klebermc/ALOS/presentation/ICCSPA2019_slides.pdf

## ALOS: Acoustic Localization System Applied to Indoor Navigation of UAVs

Kleber M. Cabral, Sergio R. B. dos Santos, Cairo L. Nascimento Jr, Sidney N. Givigi Jr.

# Agenda

- Introduction
- Position estimation problem.
- Proposed system architecture
- ALOS
- Localization algorithm
- Kalman Filter
- Results
- physical experiment using ALOS
- simulation trials
- Conclusion

# Position estimation

- Indoor environments are GPS denied
- Multiple technologies were studied throughout the years
- Infrared camera systems (OptiTrack, Vicon)
- Electromagnetic signals
- WiFi, Zigbee, Bluetooth (received power)
- UWB (TOF)
- Acoustic waves (TOF)

# Position estimation

- In general, the accuracy in position estimation with the technologies presented is:
- camera systems - centimeters or milimeters
- received power electromagnetic systems - meters or UWB - centimeters
- acoustic waves - centimeters

# Position estimation using trilateration

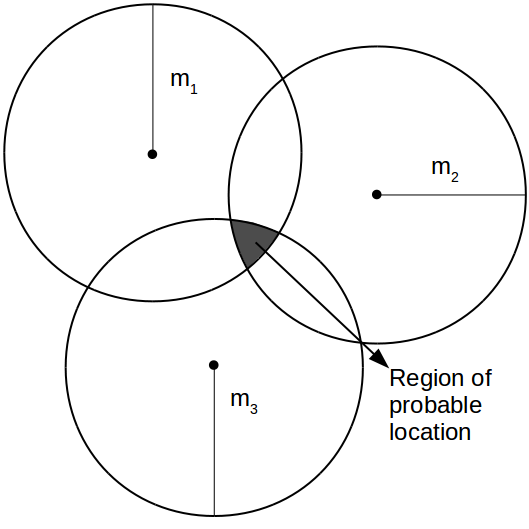
[picture p26: figure]

- It is possible to measure
the distance (mi) from a
source to a receiver
using ultrasonic sensors
- Using multiple sources,
one can calculate the
position of a receiver
with a trilateration
algorithm

# Objective

To build an ultrasonic-based indoor navigation system that is capable of compute the position and orientation of multiple aerial vehicles in real-time operation

# System proposed

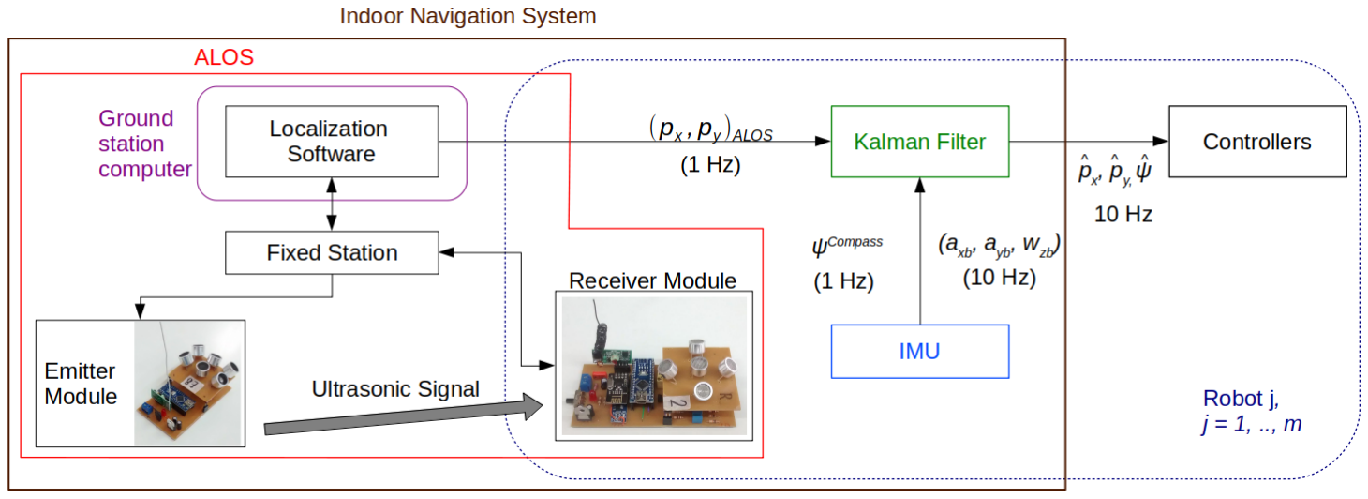
[picture p27: figure]

## ALOS (Acoustic Localization System)

- Uses ultrasonic signals to measure the distances between fixed ultrasonic emitter modules and a ultrasonic receiver coupled to a robot
- Two radio frequency channels for communication:
- 433 MHz - synchronization of operation
- 2.4 GHz - data transfer
- Uses time windows to allocate and organize the measurements of TOF. At each time window, only one of the eight emitters sends ultrasonic pulses to the environment.
- Return the position of all receiver modules every second (1 Hz)

# ALOS

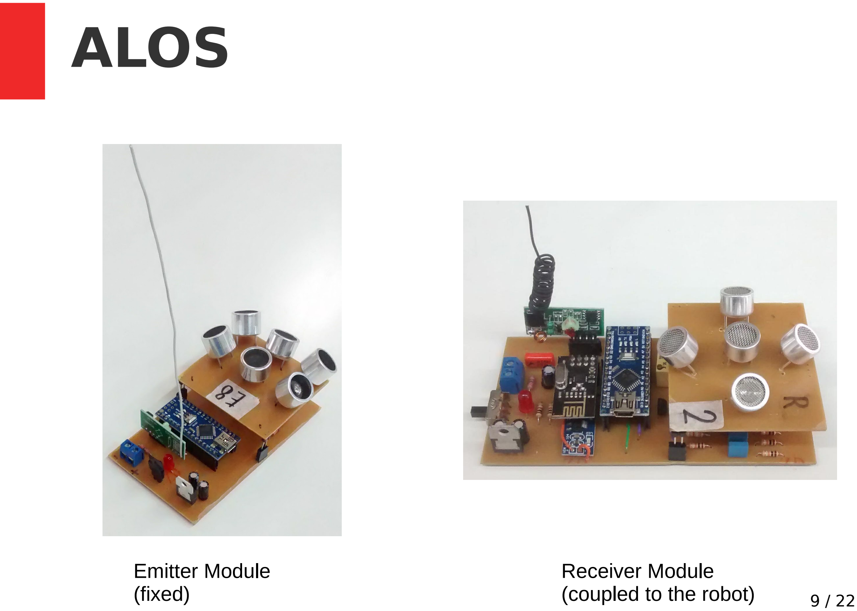
[picture p28: page 9]

Emitter Module
(fixed)

Receiver Module
(coupled to the robot)

# ALOS

- A received ultrasonic signal passes through a conditioning circuit inside Receiver Module, before being detected by the module’s microcontroller.

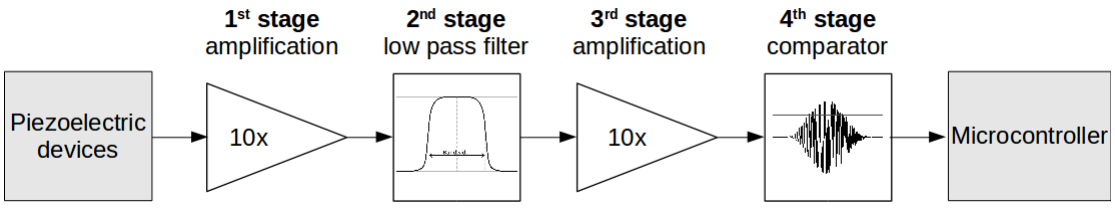
[picture p29: figure]

# ALOS: Trilateration Algorithm

- The position of a receiver module is computed by the trilateration algorithm, that uses a Taylor Series approximation of the distances measured by each ultrasonic signal.

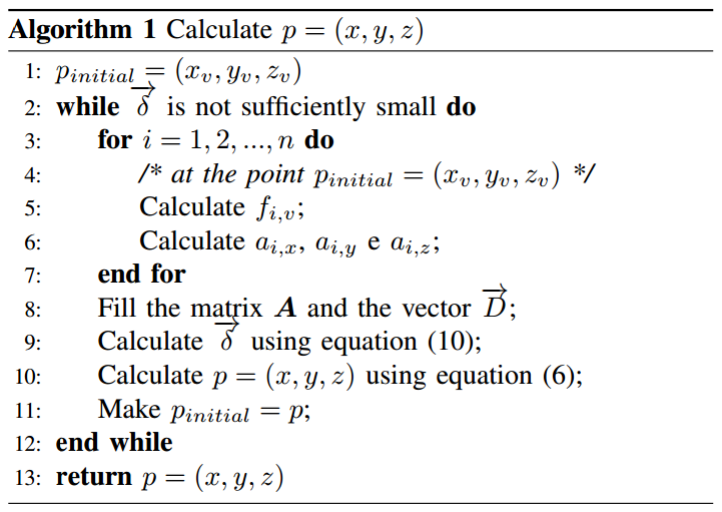
[picture p30: figure]

## Kalman Filter – Sensor fusion and Pose estimation


# Results physical experiment

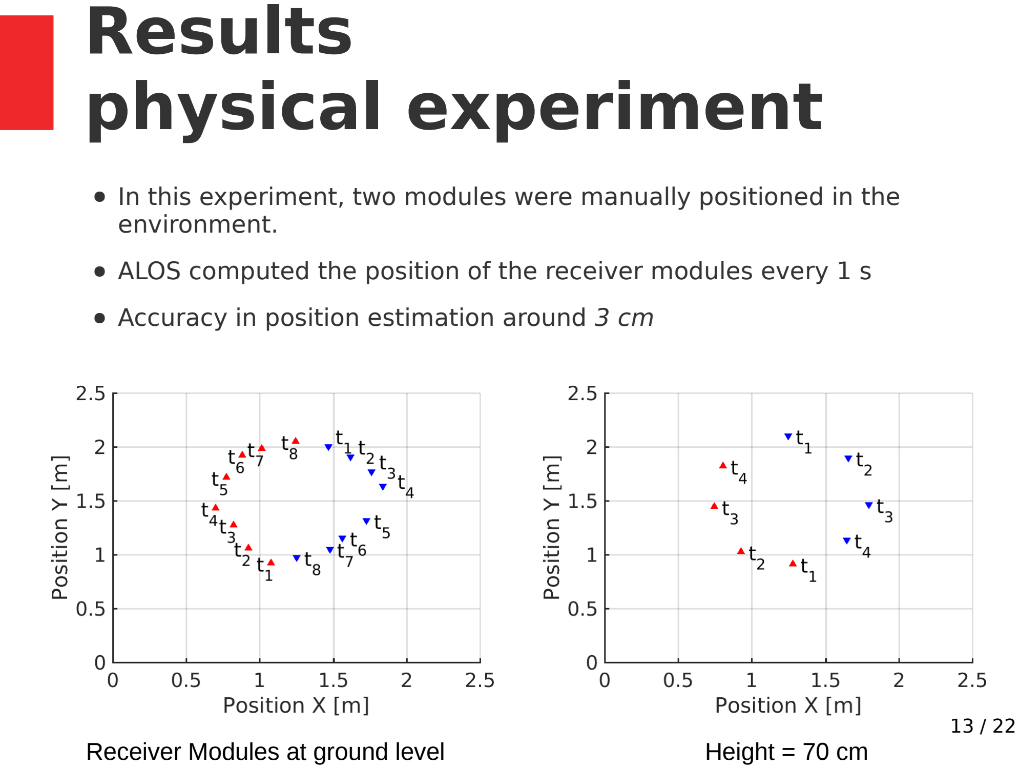
[picture p31: page 13]

- In this experiment, two modules were manually positioned in the environment.
- ALOS computed the position of the receiver modules every 1 s
- Accuracy in position estimation around 3 cm
Receiver Modules at ground level | Height = 70 cm

# Results physical experiment

- We identified that ALOS has a transport delay in the position estimation.
- Consider a receiver module physically positioned in one point in space, the computed position is only available to the robot at the end of communication and processing time.

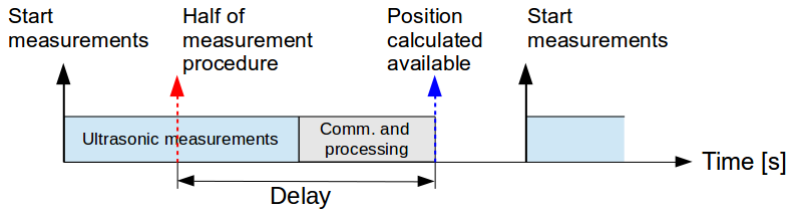
[picture p32: figure]

# Results simulation trial

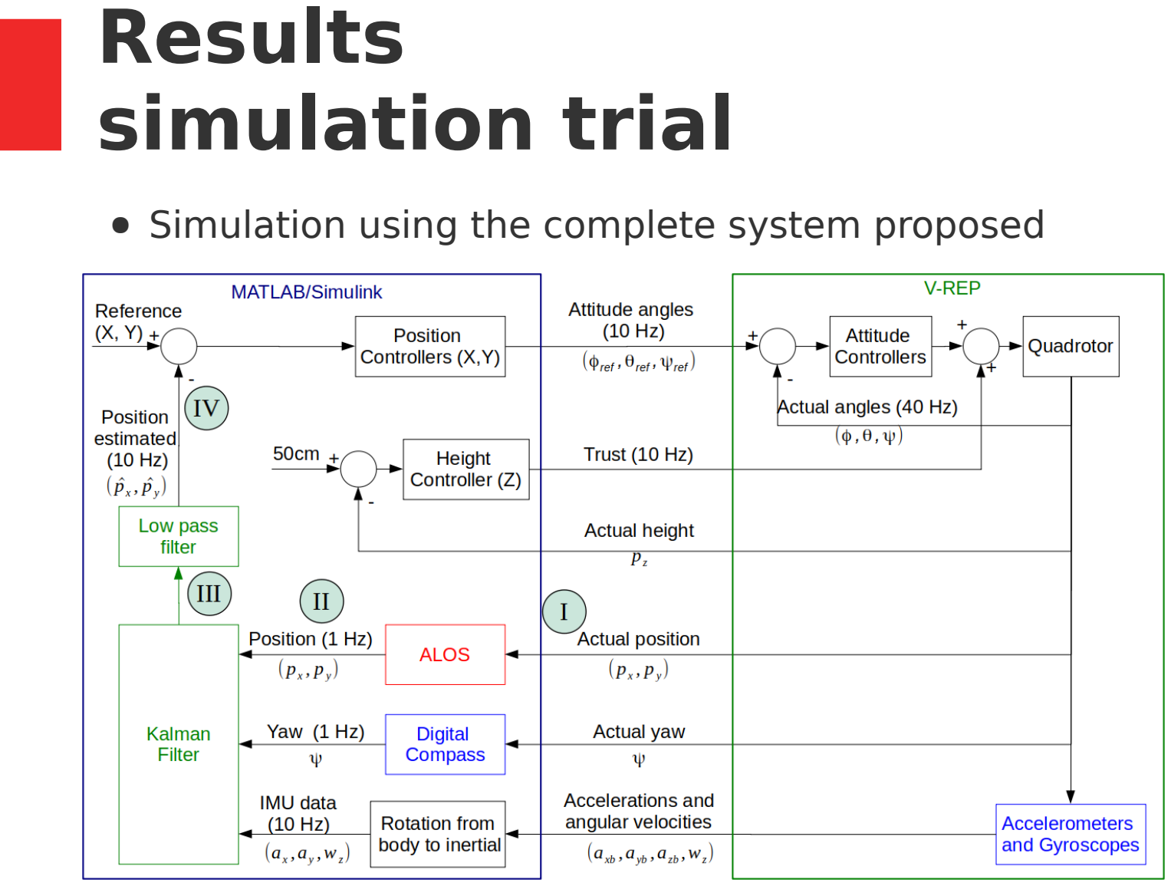
[picture p33: page 15]

- Simulation using the complete system proposed

# Results simulation trial

- Simulation environment
composed of:
- MATLAB/Simulink (position controllers, ALOS and the
Kalman Filter)
- V-Rep modules (quadrotor dynamics and attitude
controllers)
- Robot Operating System
(ROS) for communication
between softwares


# Results simulation trial

- ALOS box in is a mathematical approximation of the real system performance:
- accuracy of 3 cm;
- transport delay of 0:5 s; and
- 1 Hz operation rate.

# Results simulation trial

- ALOS box in is a mathematical approximation of the real system performance:
- accuracy of 3 cm;
- transport delay of 0:5 s; and
- 1 Hz operation rate.

# Results simulation trial

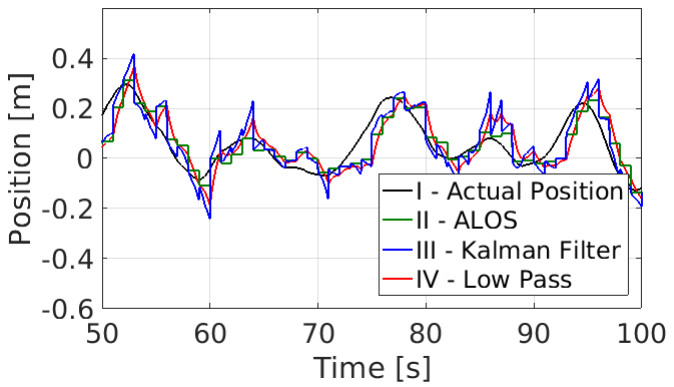
[picture p34: figure]

# Results simulation trial

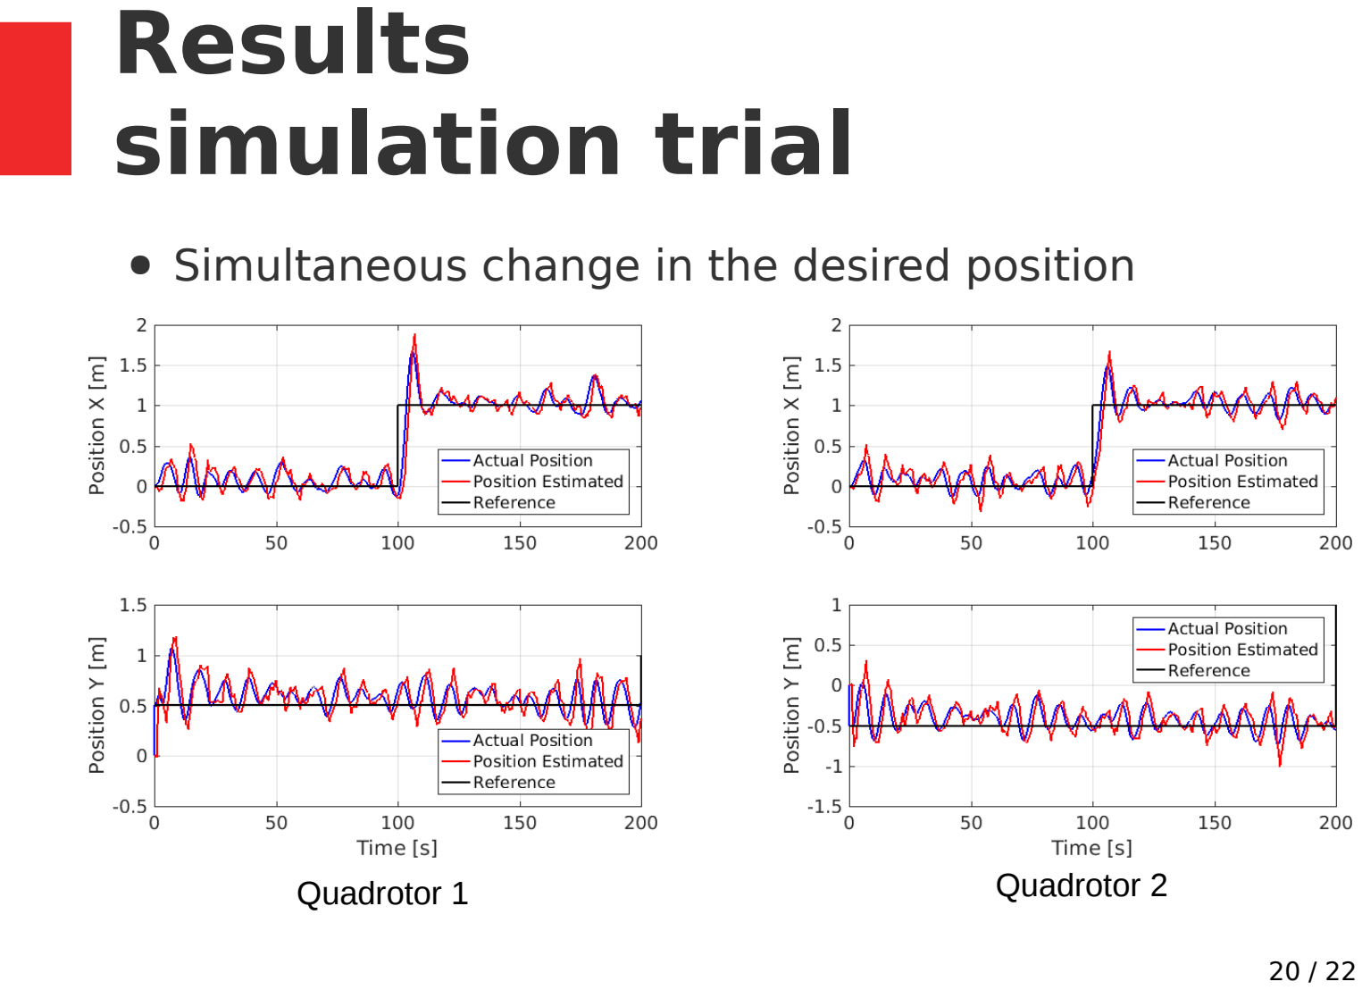
[picture p35: page 20]

Quadrotor 1 | Quadrotor 2
- Simultaneous change in the desired position

- In simulation, the error in the trajectory tracking task:
- X = 0.088 m,
- Y = 0.094 m,
- Ψ = 1.882º

RMSE between output of the Kalman Filter and the real value

# Results simulation trial

# Conclusion

- Experimental results showed the centimeter level accuracy and other parameters of ALOS.
- Autonomous flight of quadrotors made using the complete architecture proposed (in simulation trial).
- Positive features of the system:
- centimeter level accuracy of the position estimated;
- real time operation capability;
- use of low cost components for devices;
- suitability for multiple vehicle scenarios.
- Future works:
- use the complete system for real vehicles
- also investigate the applicability in land robots
