klebermc/ALOS/matlab/localization_algorithms/41L.png

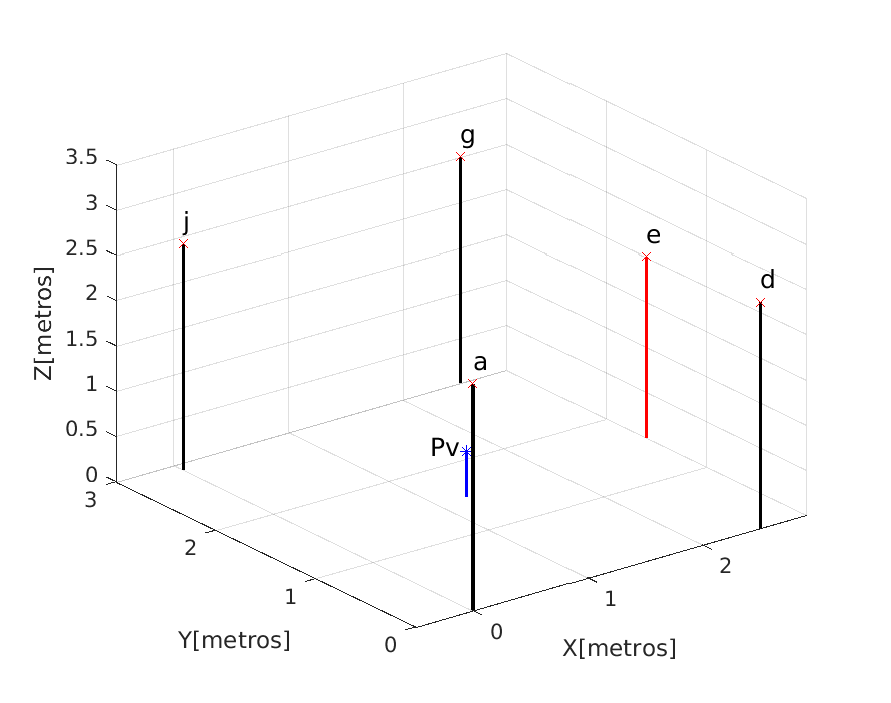
matlab/localization_algorithms/41L.png
