klebermc/ALOS/matlab/localization_algorithms/42H2L.png

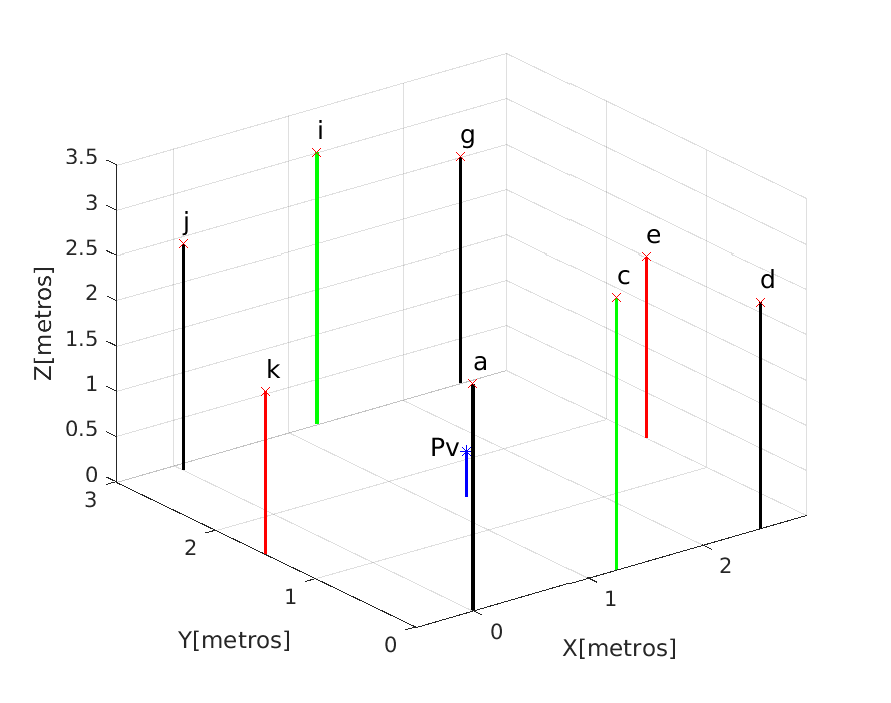
matlab/localization_algorithms/42H2L.png
