klebermc/ALOS/matlab/localization_algorithms/42H.png

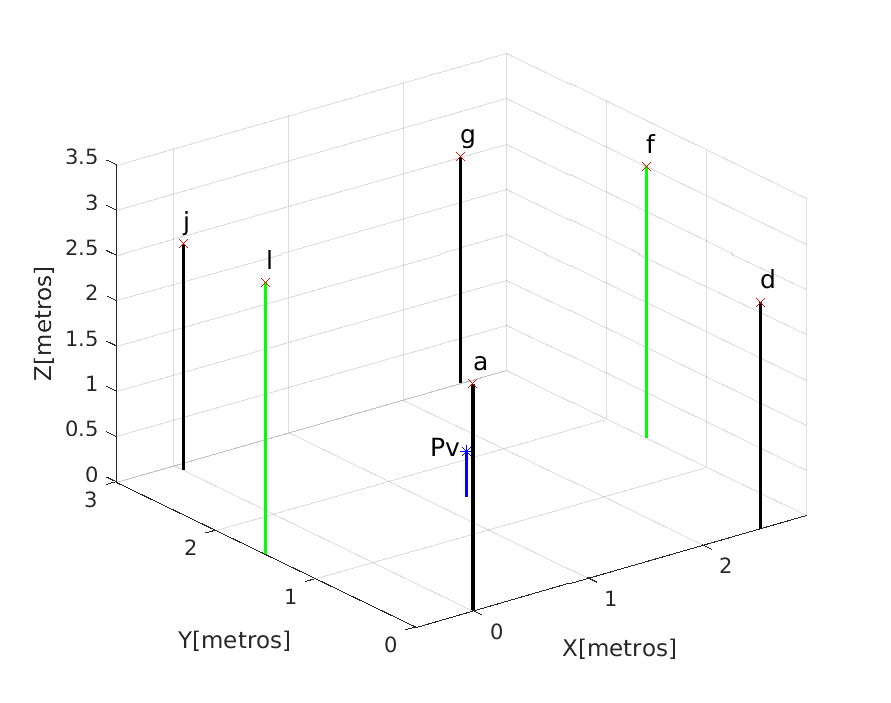
matlab/localization_algorithms/42H.png
