klebermc/ALOS/experiments/Testes_Par_Emissor_Receptor_d3m/leituras_sensor_3m_teste2.txt

1 8892
1 8880
1 8872
1 8908
1 8968
1 8924
1 8896
1 8872
1 8912
1 8920
1 8968
1 8940
1 8920
1 8916
1 8924
1 8940
1 8948
1 8880
1 8916
1 8896
1 8912
1 8948
1 8896
1 8924
1 8924
1 8940
1 8900
1 8924
1 8936
1 8868
1 8956
1 8960
1 8900
1 8928
1 8916
1 8940
1 8912
1 8924
1 8940
1 8940
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
