klebermc/ALOS/experiments/Testes_Par_Emissor_Receptor_d3m/leituras_sensor_3m_teste3.txt

0 8876
1 8900
2 8952
3 8932
4 8924
5 8924
6 8940
7 8884
8 8928
9 8912
10 8924
11 8920
12 8936
13 8880
14 8924
15 8908
16 8924
17 8932
18 8876
19 8944
20 8944
21 8920
22 8944
23 8948
24 8932
25 8904
26 8900
27 8948
28 8892
29 8932
30 8904
31 8952
32 8904
33 8924
34 8940
35 8888
36 8924
37 8912
38 8872
39 8908
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
