klebermc/ALOS/experiments/quadrotor_real/IMU_on_quad/testes_quad_resultados.txt

teste 1 - tudo parado sem girar hélice

teste 2 - parado com hélice girando 

teste 3 - quadrotor voando

teste 4 - 'voando' com hélice desligada
