klebermc/ALOS/experiments/quadrotor_real/Voo_quad_outdoor/dados_teste1.txt

count pitch roll yaw
1 0.0214 -0.0676 -0.0366
2 0.0720 -0.1110 -0.2228
3 0.1178 -0.0892 -0.4440
4 0.0580 -0.0696 -0.4516
5 0.0622 -0.0908 -0.7924
6 0.0668 -0.0180 -0.8650
7 0.1318 0.0106 -1.2314
8 0.1760 -0.0408 -1.3010
9 0.1214 -0.0116 -1.5908
10 0.0988 0.0404 -2.0344
11 0.1584 -0.0524 -2.7096
12 -0.0202 0.0982 -3.3364
13 0.0260 0.0446 -3.9764
14 0.1462 -0.1000 -4.7684
15 0.1454 -0.1278 -4.4338
16 0.1358 -0.0426 -6.4216
17 0.0686 0.0948 -7.4976
18 0.0670 0.0516 -8.6750
19 0.1370 -0.0826 -9.9736
20 0.1466 -0.1068 -11.4426
21 0.0220 -0.0182 -2.4790
22 0.3678 -0.2304 -15.8650
23 0.3728 -0.2594 -17.6918
24 0.3300 -0.1598 -20.0174
25 0.3210 -0.1234 -22.6536
26 0.3052 -0.1014 -25.6576
27 0.3008 -0.1726 -22.9736
28 0.3020 -0.1924 -32.1342
29 0.1982 -0.1132 -36.4076
30 0.2452 -0.1578 -40.8928
31 0.2710 -0.1578 -45.6752
32 0.2574 -0.1460 -50.9192
33 0.3144 -0.1450 -56.7166
34 0.5200 -0.3270 -62.8982
35 0.3576 -0.1256 -69.4396
36 0.1946 -0.0878 -76.2902
37 0.1762 -0.0588 -66.0804
38 0.3126 -0.1782 -89.0086
39 0.2884 -0.1590 -96.1306
40 0.3262 -0.1700 -103.1706
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
count pitch roll yaw
1 -0.0876 0.0478 -0.0112
2 -0.1254 0.0918 2.6288
3 -0.0354 0.0012 6.9594
4 -0.0144 -0.0032 14.8692
5 -0.1642 0.1598 21.8110
6 -0.1200 0.0012 28.7510
7 -0.0250 -0.1422 35.5856
8 0.0106 -0.1446 42.2834
9 -0.0800 -0.0176 48.6348
10 -0.0486 -0.0964 54.6636
11 -0.0530 -0.0730 60.2804
12 -0.2026 0.0028 65.4612
13 -0.1786 0.0290 70.1820
14 -0.1238 -0.0824 74.4888
15 -0.0148 -0.1254 62.4558
16 0.0018 -0.1016 81.2252
17 0.0288 -0.0688 84.3802
18 0.0118 0.0626 87.3352
19 -0.0286 -0.0068 90.0342
20 -0.0108 0.0018 92.2064
21 -0.0696 0.1944 75.3342
22 -0.1142 0.2208 95.8246
23 0.0826 -0.0316 97.3816
24 0.1640 -0.1638 98.7780
25 -0.0068 -0.0524 100.0818
26 -0.1206 -0.0658 101.2784
27 -0.0130 -0.2198 102.2904
28 0.0646 -0.1972 103.0922
29 0.0244 -0.1620 103.8322
30 -0.0086 -0.1560 83.6004
31 -0.0698 -0.0466 84.0784
32 0.0588 -0.2284 105.5558
33 -0.0554 -0.0986 105.9798
34 -0.0708 -0.2450 106.4208
35 -0.0822 -0.2518 106.8892
36 -0.2842 0.1278 107.2848
37 -0.3768 0.1446 107.5212
38 -0.0788 -0.0430 86.1026
39 0.0050 -0.1008 107.7462
40 0.1206 -0.0908 107.9370
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
count pitch roll yaw
1 0.0306 -0.0314 -0.0370
2 0.1016 -0.0010 2.6608
3 0.2980 -0.0714 9.5920
4 0.2232 -0.0770 12.6496
5 0.4744 -0.0724 21.9470
6 0.4680 -0.0504 28.5752
7 0.3012 -0.0108 34.9452
8 0.3110 -0.1742 40.9124
9 0.3690 -0.1422 46.4550
10 0.2856 0.0958 51.6772
11 0.1008 0.2618 56.3970
12 -0.0252 0.2732 60.7162
13 -0.1230 0.0786 64.6342
14 -0.0702 -0.0890 54.2460
15 -0.1314 -0.0130 70.6752
16 -0.0620 0.0616 73.5504
17 -0.1914 0.2164 76.1652
18 0.0078 0.0058 78.4832
19 0.1256 -0.0216 80.5012
20 0.2588 -0.1250 82.3362
21 0.1520 0.0426 84.0824
22 0.2762 -0.1396 68.3374
23 0.2850 -0.1956 86.5236
24 0.2842 -0.2456 87.5510
25 0.2480 -0.2962 88.5132
26 0.3998 -0.3618 89.2302
27 0.2798 -0.1628 89.9542
28 0.0364 0.0610 90.5336
29 0.0858 0.2958 91.0348
30 0.1050 0.2368 73.2250
31 0.2498 -0.0196 92.0924
32 0.0882 0.0474 92.6748
33 0.0158 0.1696 93.1676
34 0.0242 0.1384 93.5484
35 0.0864 0.0378 93.7802
36 0.0998 -0.0178 93.8542
37 0.1020 -0.0348 75.1948
38 0.1260 -0.0850 94.1676
39 -0.0190 0.0356 94.3508
40 0.0272 0.1914 94.5150
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
