klebermc/ALOS/experiments/quadrotor_real/Voo_quad_outdoor/dados_teste2.txt

count	pitch	roll	yaw
1	0.0198	-0.0044	-0.0226
2	0.1364	0.0374	2.7210
3	0.1014	-0.0074	7.1182
4	0.1340	-0.0912	14.9020
5	0.0620	-0.1276	21.3752
6	0.0738	-0.1058	27.4978
7	0.0590	-0.1202	33.2176
8	-0.0118	-0.2196	38.5034
9	-0.0156	-0.3448	43.2880
10	-0.0282	-0.3390	47.7944
11	0.0454	-0.3180	51.7982
12	0.0010	-0.3630	55.4534
13	0.0330	-0.3044	58.7534
14	0.0220	-0.2064	49.1052
15	0.0178	-0.2660	63.5732
16	0.0022	-0.2780	65.8586
17	0.0592	-0.2786	67.9860
18	0.0202	-0.2602	69.9148
19	0.0058	-0.2228	71.5772
20	-0.0002	-0.1738	73.0450
21	0.0260	-0.1170	59.4038
22	0.0104	-0.1656	75.3070
23	0.0122	-0.1994	76.3836
24	-0.0044	-0.1264	77.4188
25	0.0104	-0.1238	78.2380
26	-0.0108	-0.1146	78.9046
27	0.0332	-0.1362	79.4938
28	0.0508	-0.0702	80.0170
29	0.0874	-0.0906	64.3522
30	0.1056	-0.0876	80.8050
31	0.1224	-0.2182	81.2470
32	0.1068	-0.2742	81.6504
33	0.1180	-0.2142	82.0190
34	0.1652	-0.2286	82.3492
35	0.1200	-0.2826	82.6266
36	0.0462	-0.3876	82.8210
37	0.0300	-0.4262	66.4690
38	0.0096	-0.6702	83.1860
39	-0.0020	-0.3198	83.2284
40	-0.0100	-0.2326	83.3298
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
