klebermc/ALOS/experiments/acceleration.png

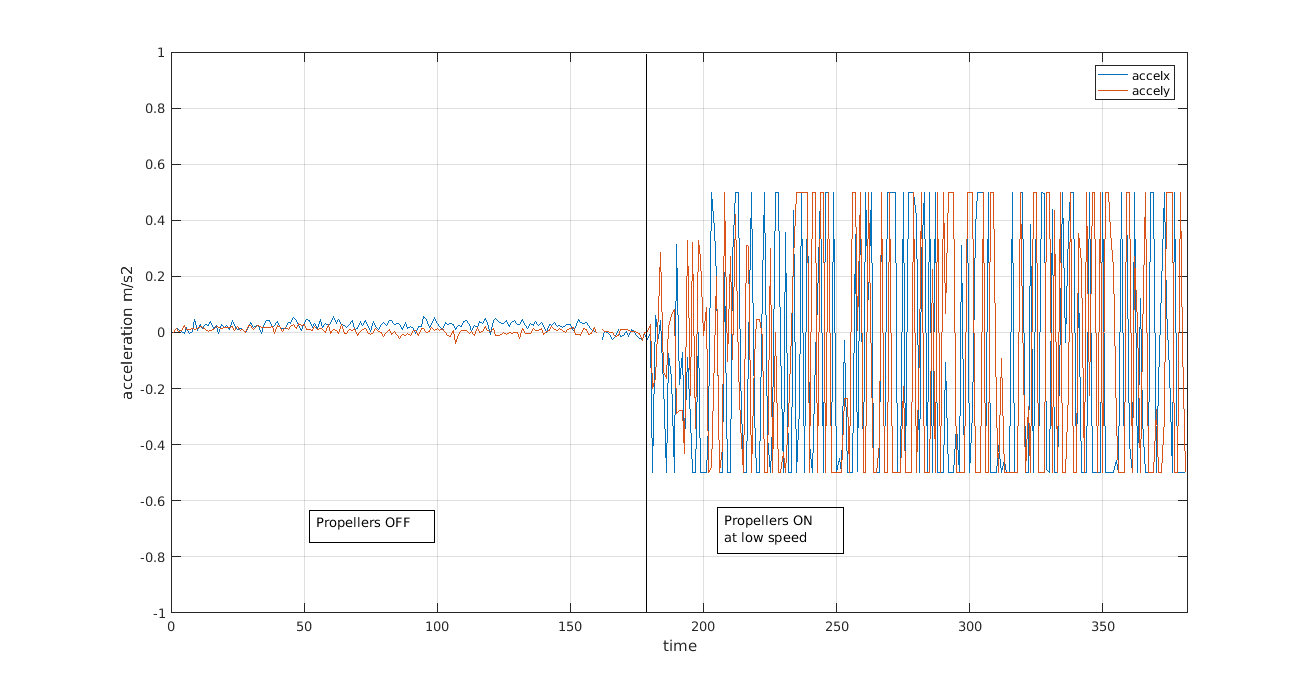
experiments/acceleration.png
