klebermc/ALOS/experiments/Calculo_pos_lms_ts_aml/p1_aml.png

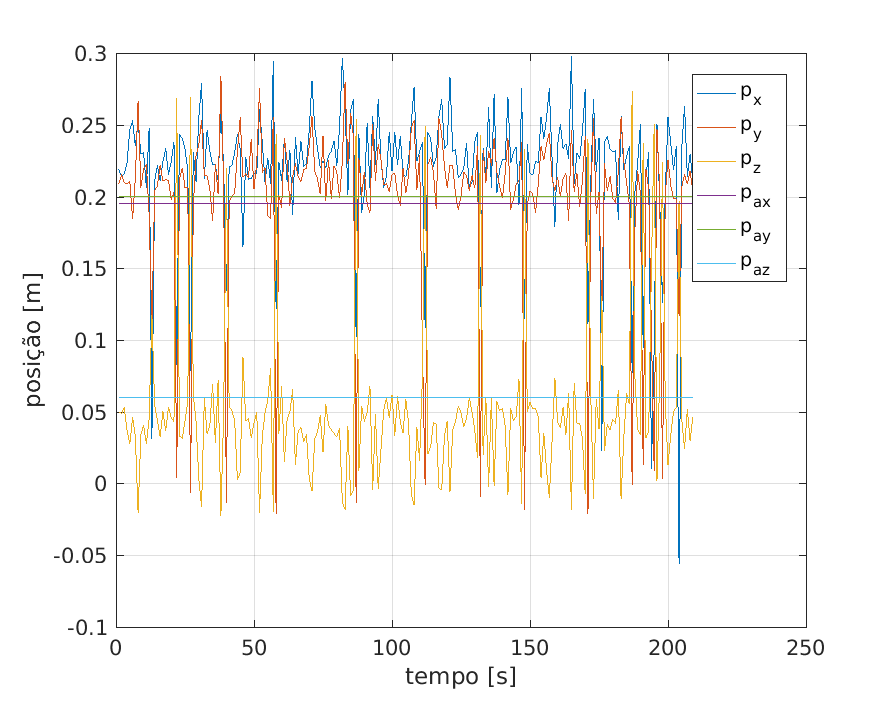
experiments/Calculo_pos_lms_ts_aml/p1_aml.png
