klebermc/ALOS/experiments/Calculo_pos_lms_ts_aml/p1_lms.png

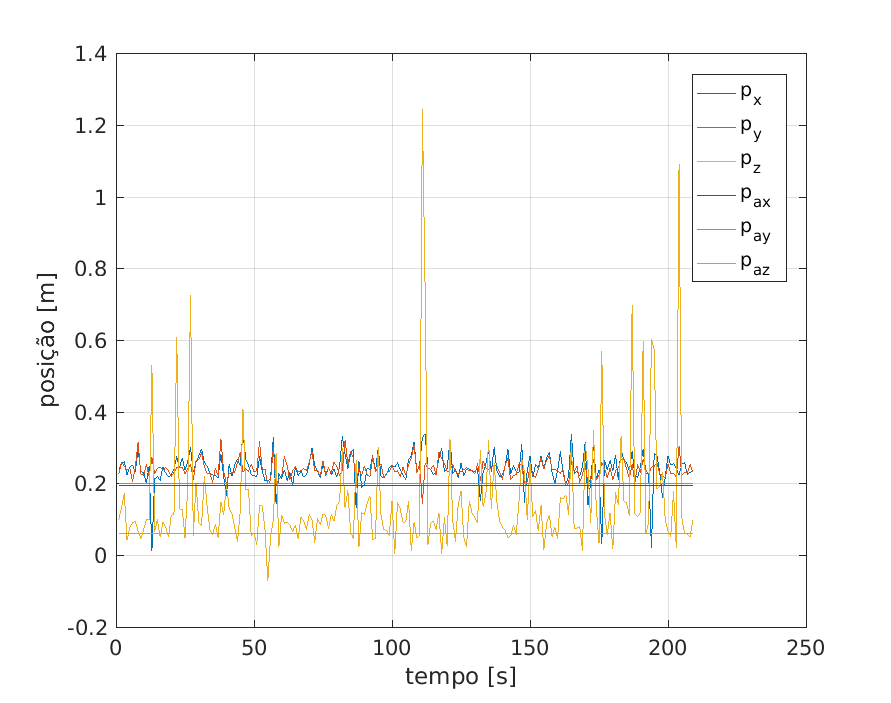
experiments/Calculo_pos_lms_ts_aml/p1_lms.png
