klebermc/ALOS/experiments/Calculo_pos_lms_ts_aml/pos_xyz_calib_lms.png

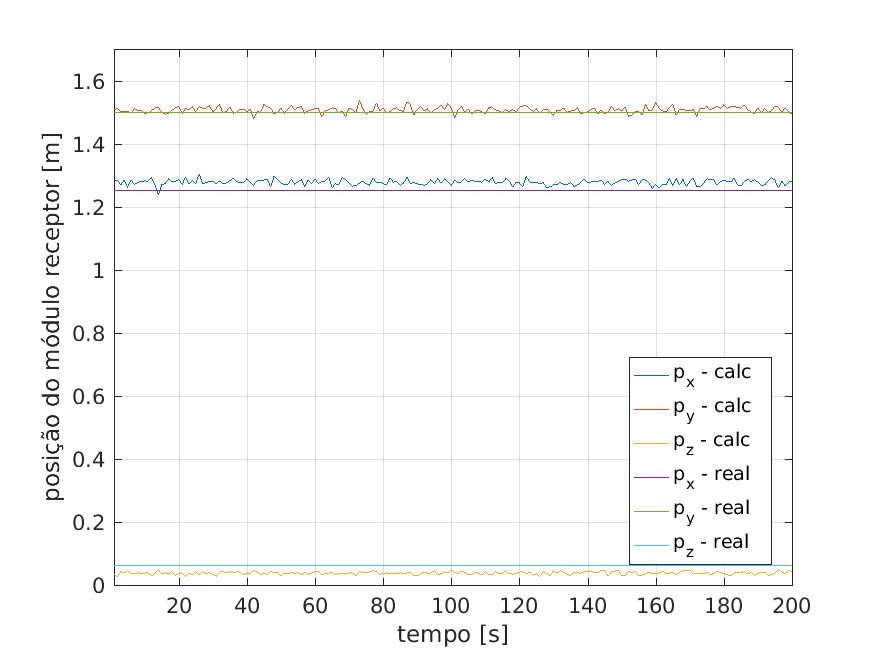
experiments/Calculo_pos_lms_ts_aml/pos_xyz_calib_lms.png
