klebermc/ALOS/experiments/Calculo_pos_lms_ts_aml/vel_calib_ls.png

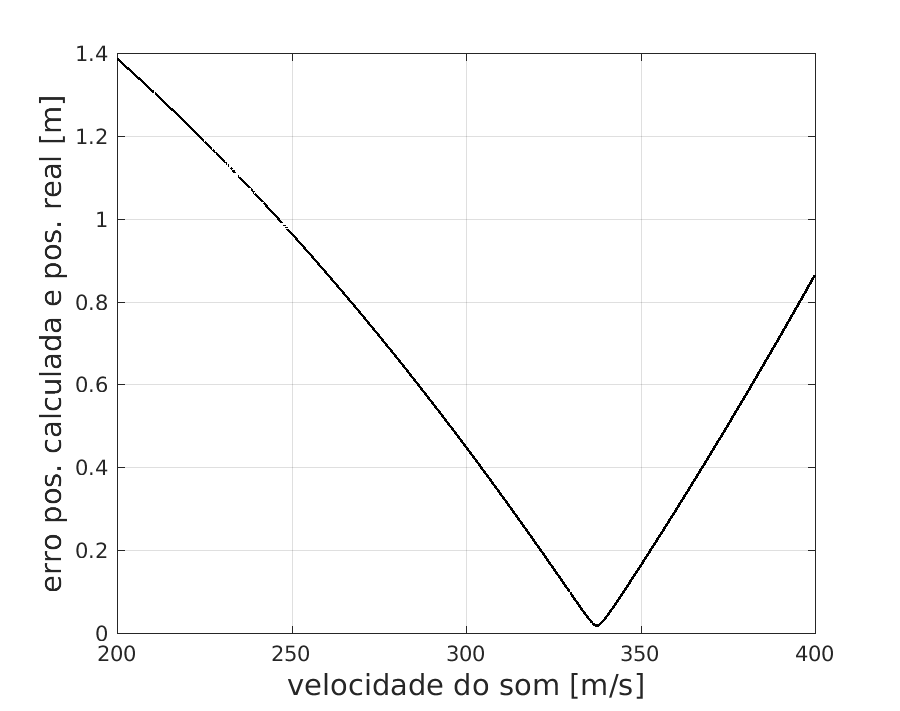
experiments/Calculo_pos_lms_ts_aml/vel_calib_ls.png
