klebermc/ALOS/experiments/Calculo_pos_lms_ts_aml/vel_calib_ls_ts.png

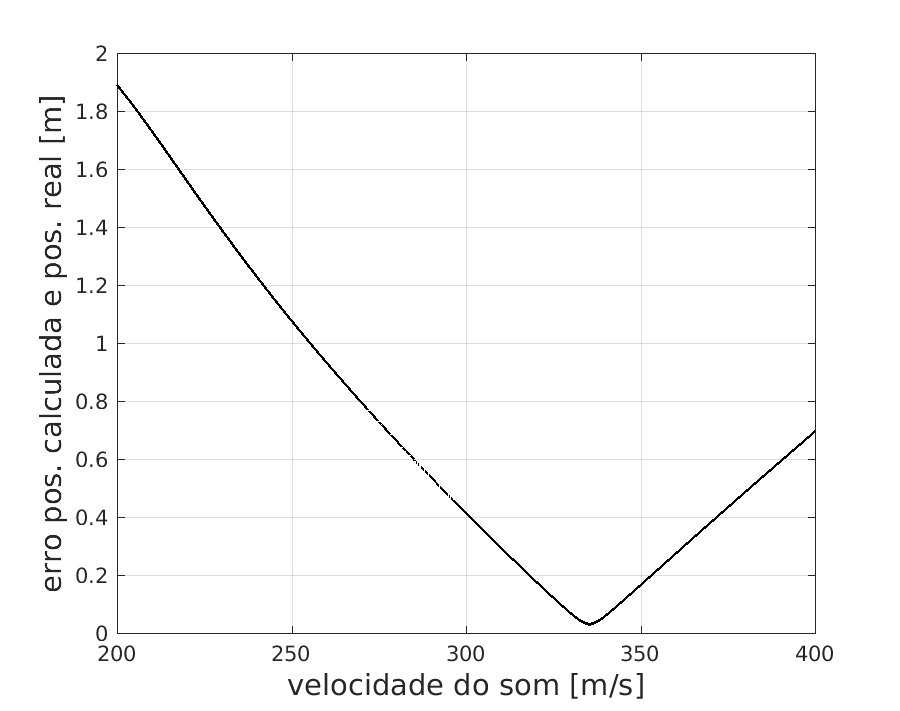
experiments/Calculo_pos_lms_ts_aml/vel_calib_ls_ts.png
