klebermc/ALOS/experiments/Comparacao_LMS_TS/ponto5.png

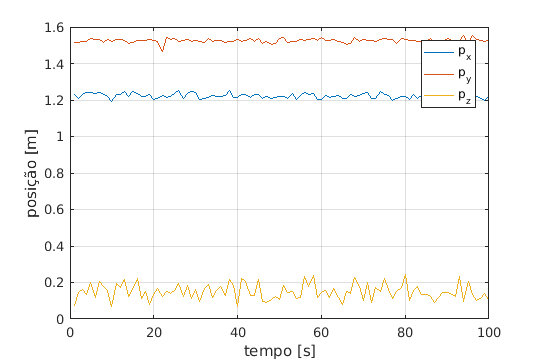
experiments/Comparacao_LMS_TS/ponto5.png
