klebermc/ALOS/experiments/Estudo_Caso_1_Robo_Solo/exp4_completo/teste4.png

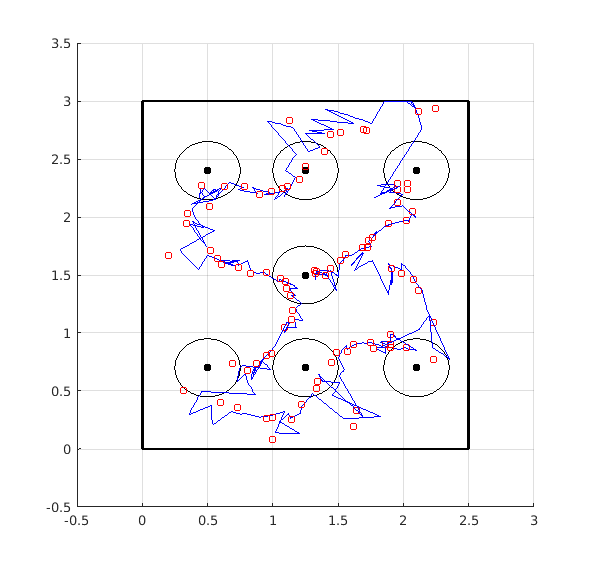
experiments/Estudo_Caso_1_Robo_Solo/exp4_completo/teste4.png
