klebermc/ALOS/experiments/Estudo_Caso_1_Robo_Solo/exp5_falha_SILA_bussola/teste2_estados.png

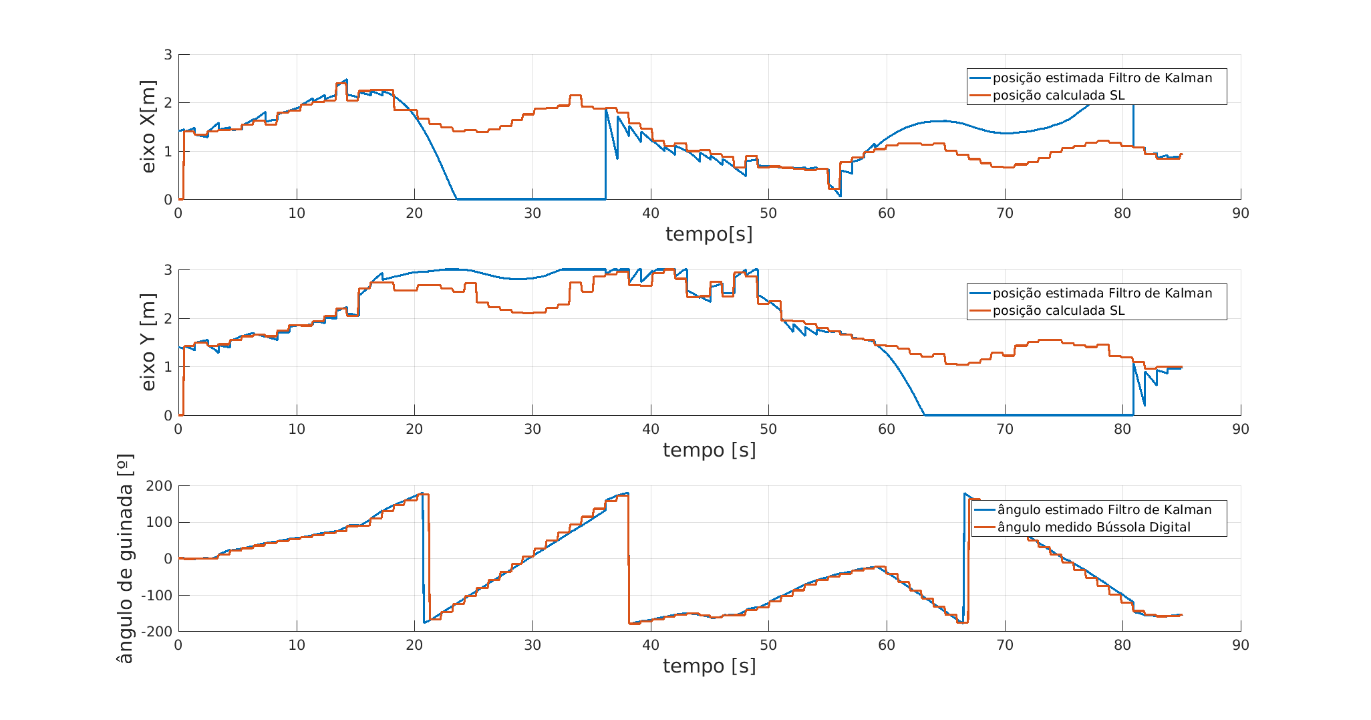
experiments/Estudo_Caso_1_Robo_Solo/exp5_falha_SILA_bussola/teste2_estados.png
