klebermc/ALOS/experiments/Estudo_Caso_1_Robo_Solo/exp5_falha_SILA_bussola/teste4.png

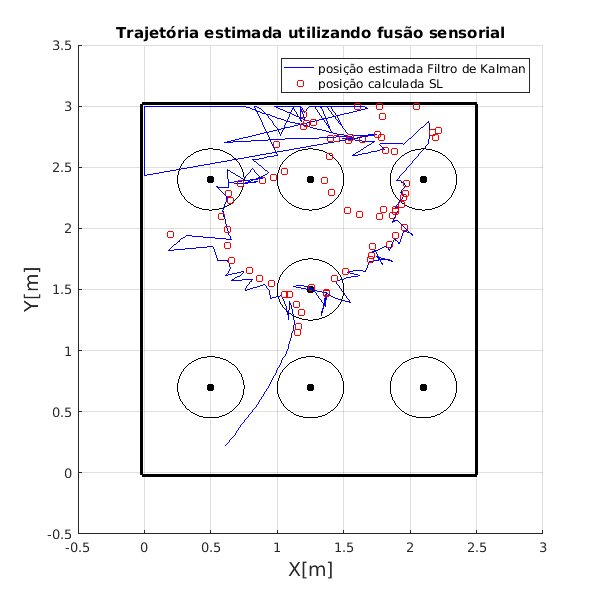
experiments/Estudo_Caso_1_Robo_Solo/exp5_falha_SILA_bussola/teste4.png
