klebermc/ALOS/experiments/Estudo_Caso_2_Quad_Simulado/imagens_iniciais/atraso_1_noPID_completo.png

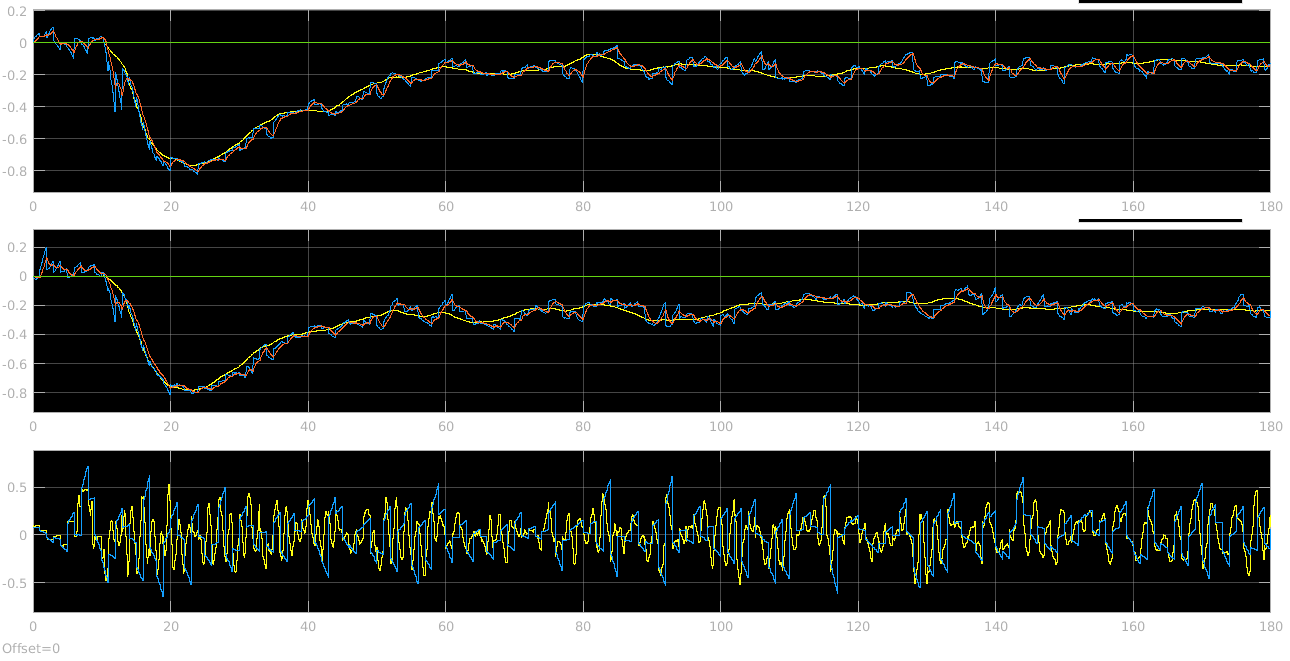
experiments/Estudo_Caso_2_Quad_Simulado/imagens_iniciais/atraso_1_noPID_completo.png
