klebermc/ALOS/experiments/Estudo_Caso_2_Quad_Simulado/imagens_iniciais/pid3.png

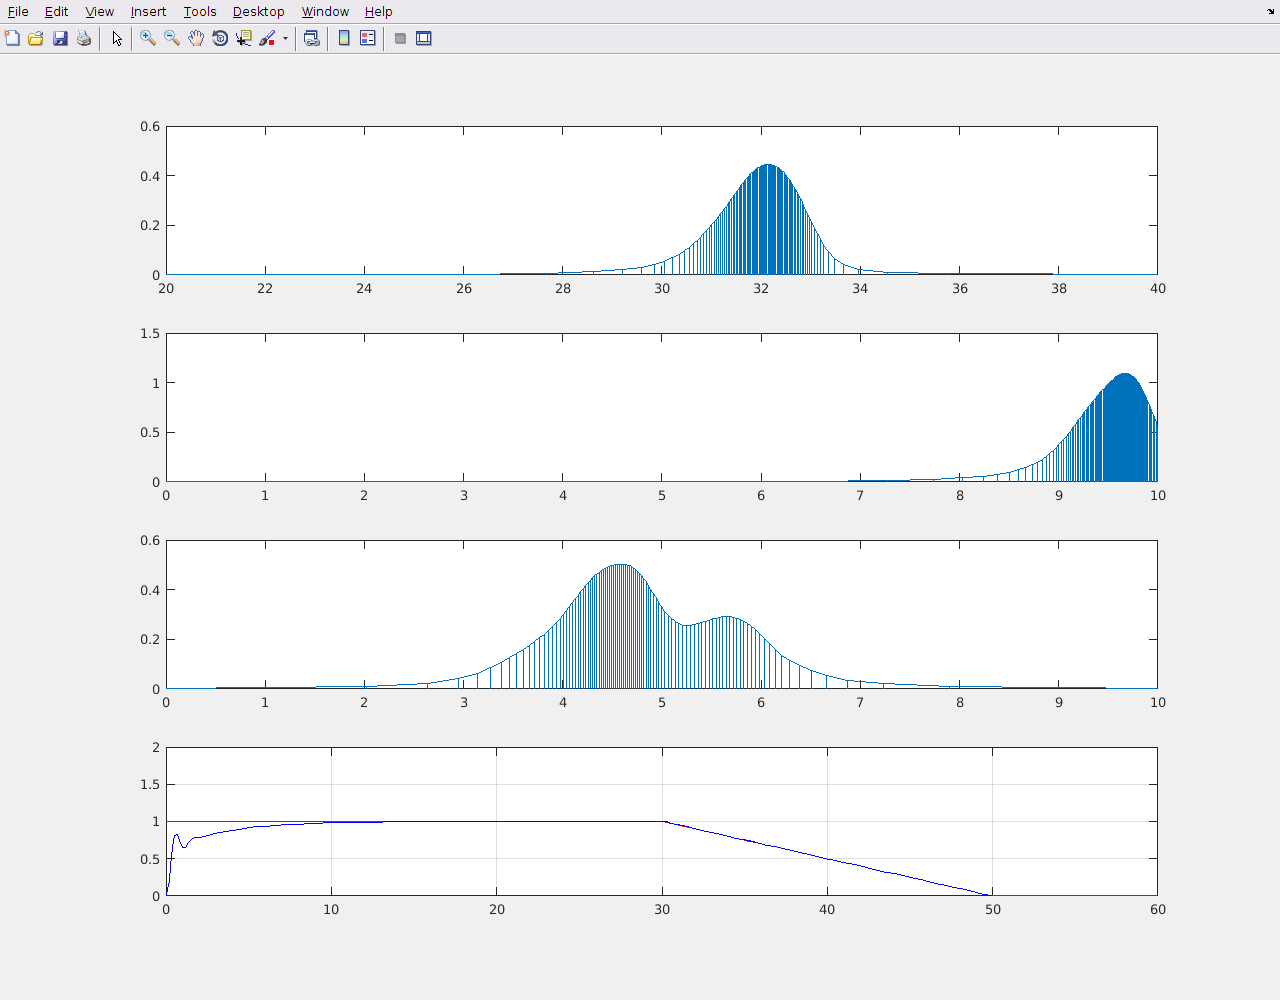
experiments/Estudo_Caso_2_Quad_Simulado/imagens_iniciais/pid3.png
