klebermc/ALOS/experiments/quadrotor_real/IMU_on_quad/FiltroEmbutido/f3hz.png

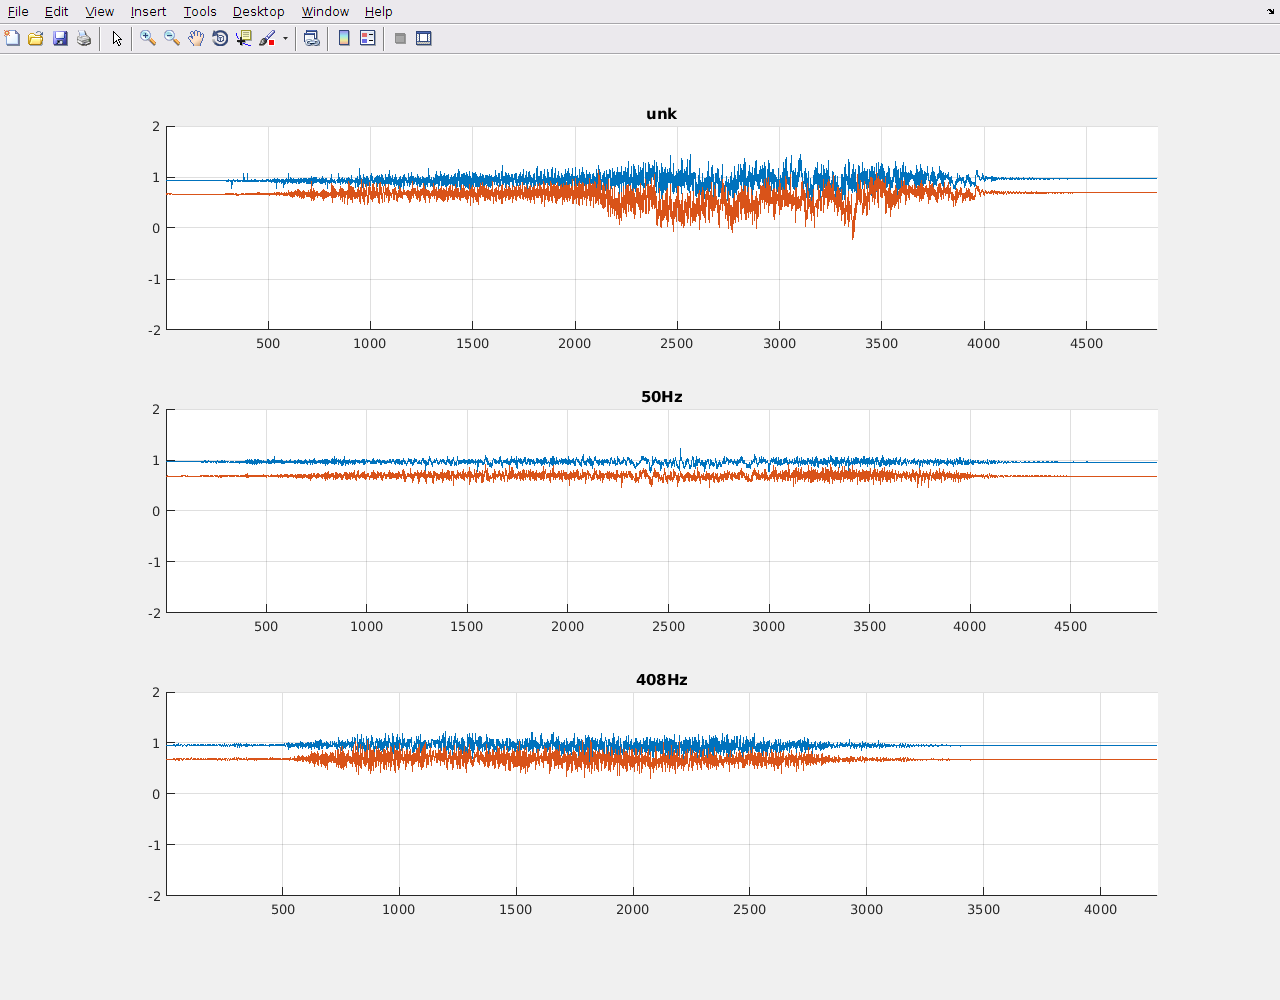
experiments/quadrotor_real/IMU_on_quad/FiltroEmbutido/f3hz.png
