klebermc/ALOS/experiments/quadrotor_real/IMU_on_quad/FiltroEmbutido/f10Hz.png

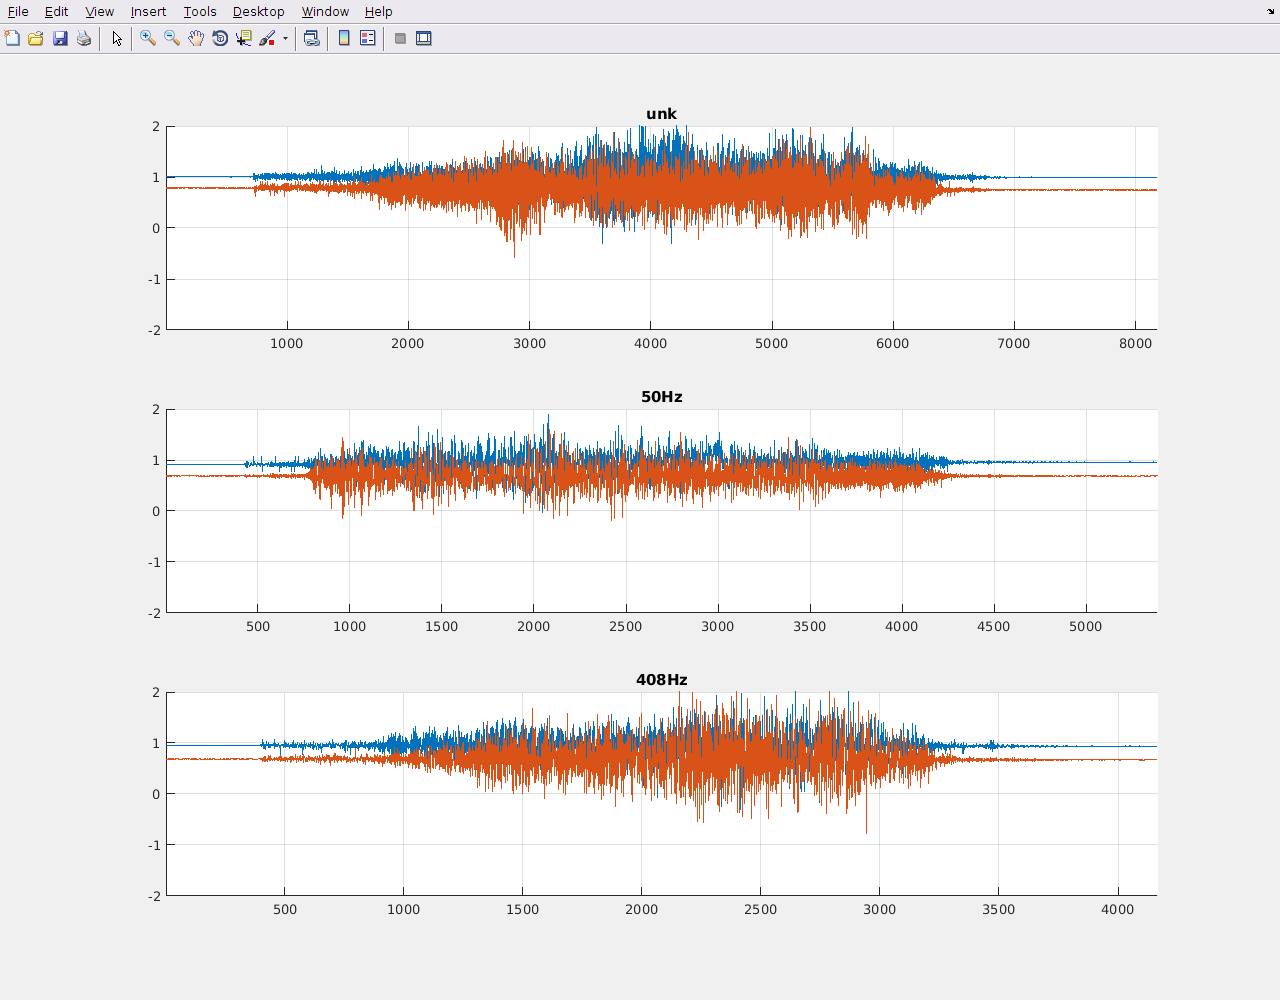
experiments/quadrotor_real/IMU_on_quad/FiltroEmbutido/f10Hz.png
