klebermc/ALOS/experiments/quadrotor_real/IMU_on_quad/FiltroEmbutido/f19hz.png

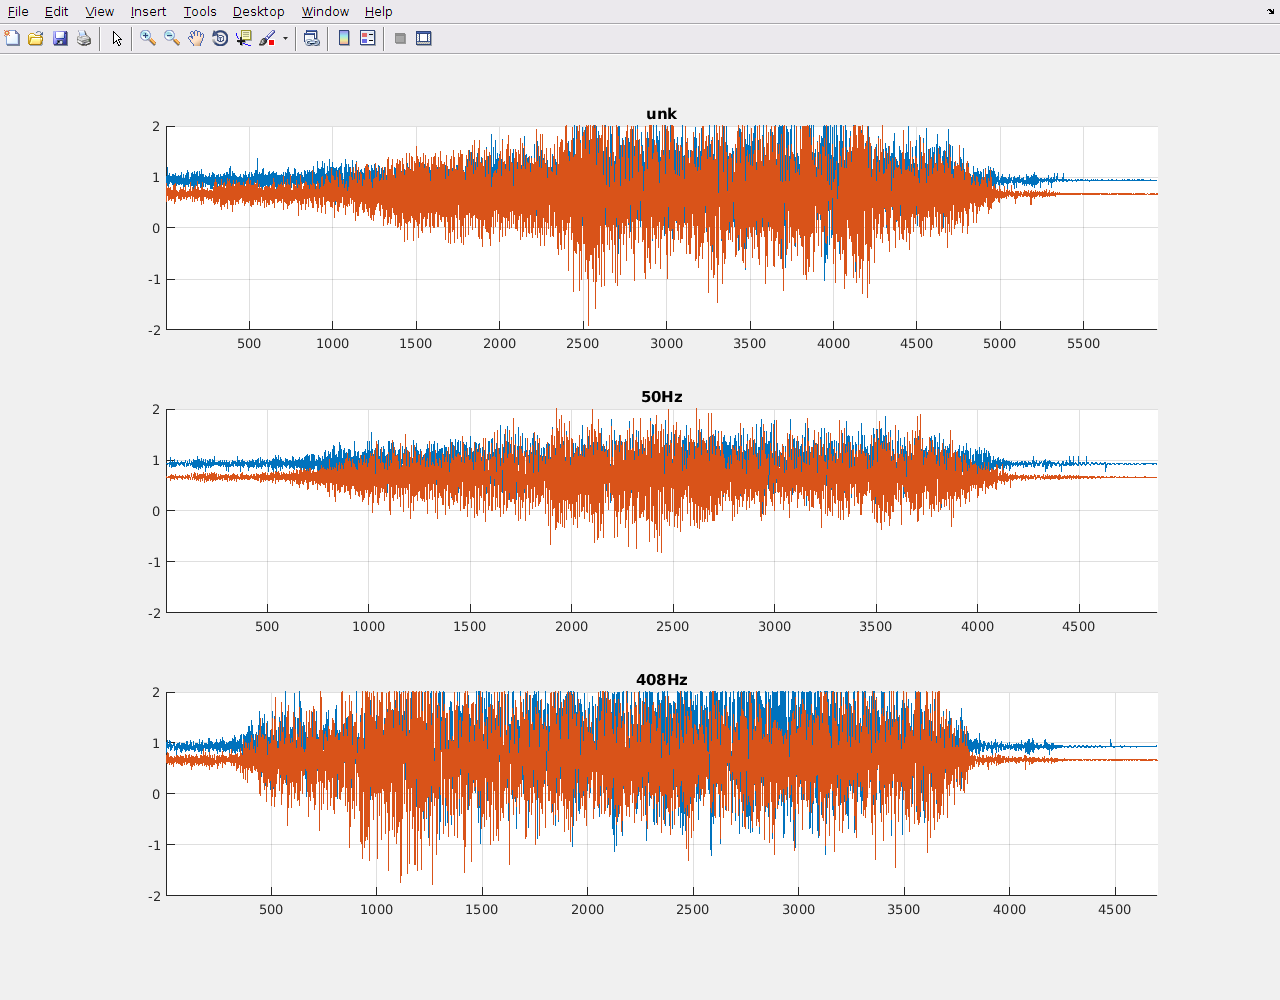
experiments/quadrotor_real/IMU_on_quad/FiltroEmbutido/f19hz.png
