klebermc/ALOS/experiments/quadrotor_real/IMU_on_quad/teste2_fft.png

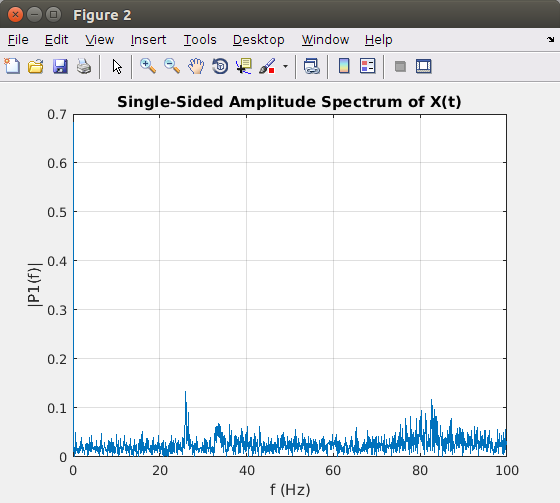
experiments/quadrotor_real/IMU_on_quad/teste2_fft.png
