klebermc/ALOS/experiments/quadrotor_real/IMU_on_quad/teste4_1_fft.png

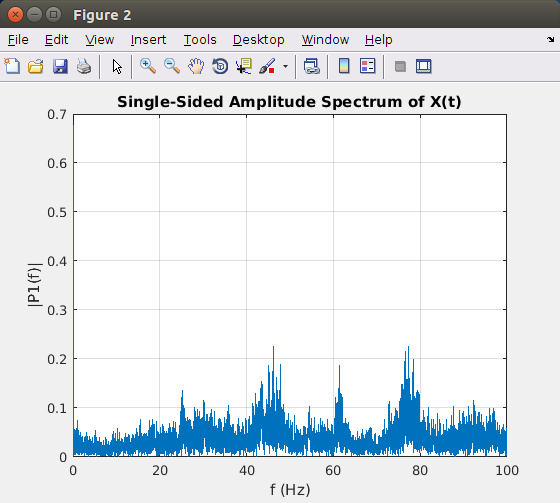
experiments/quadrotor_real/IMU_on_quad/teste4_1_fft.png
