klebermc/ALOS/experiments/quadrotor_real/IMU_on_quad/teste4_2_fft.png

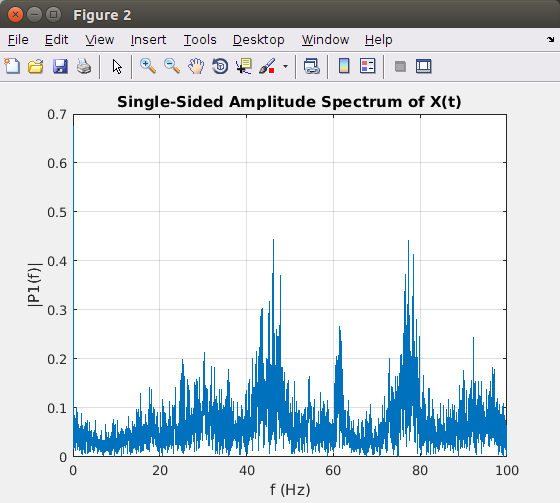
experiments/quadrotor_real/IMU_on_quad/teste4_2_fft.png
