klebermc/ALOS/experiments/Testes_Par_Emissor_Receptor_d3m/histograma_dist2.png

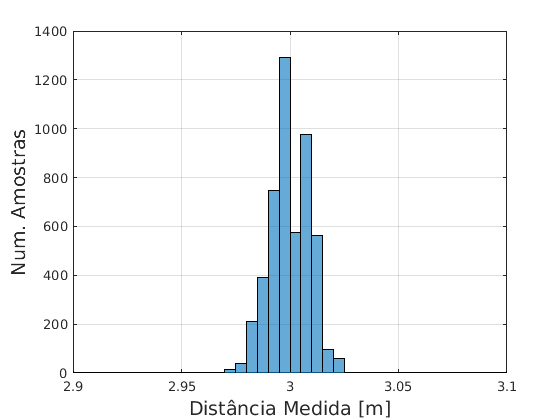
experiments/Testes_Par_Emissor_Receptor_d3m/histograma_dist2.png
