klebermc/ALOS/hardware/emitter/Emissor schematic.pdf

J7

U2

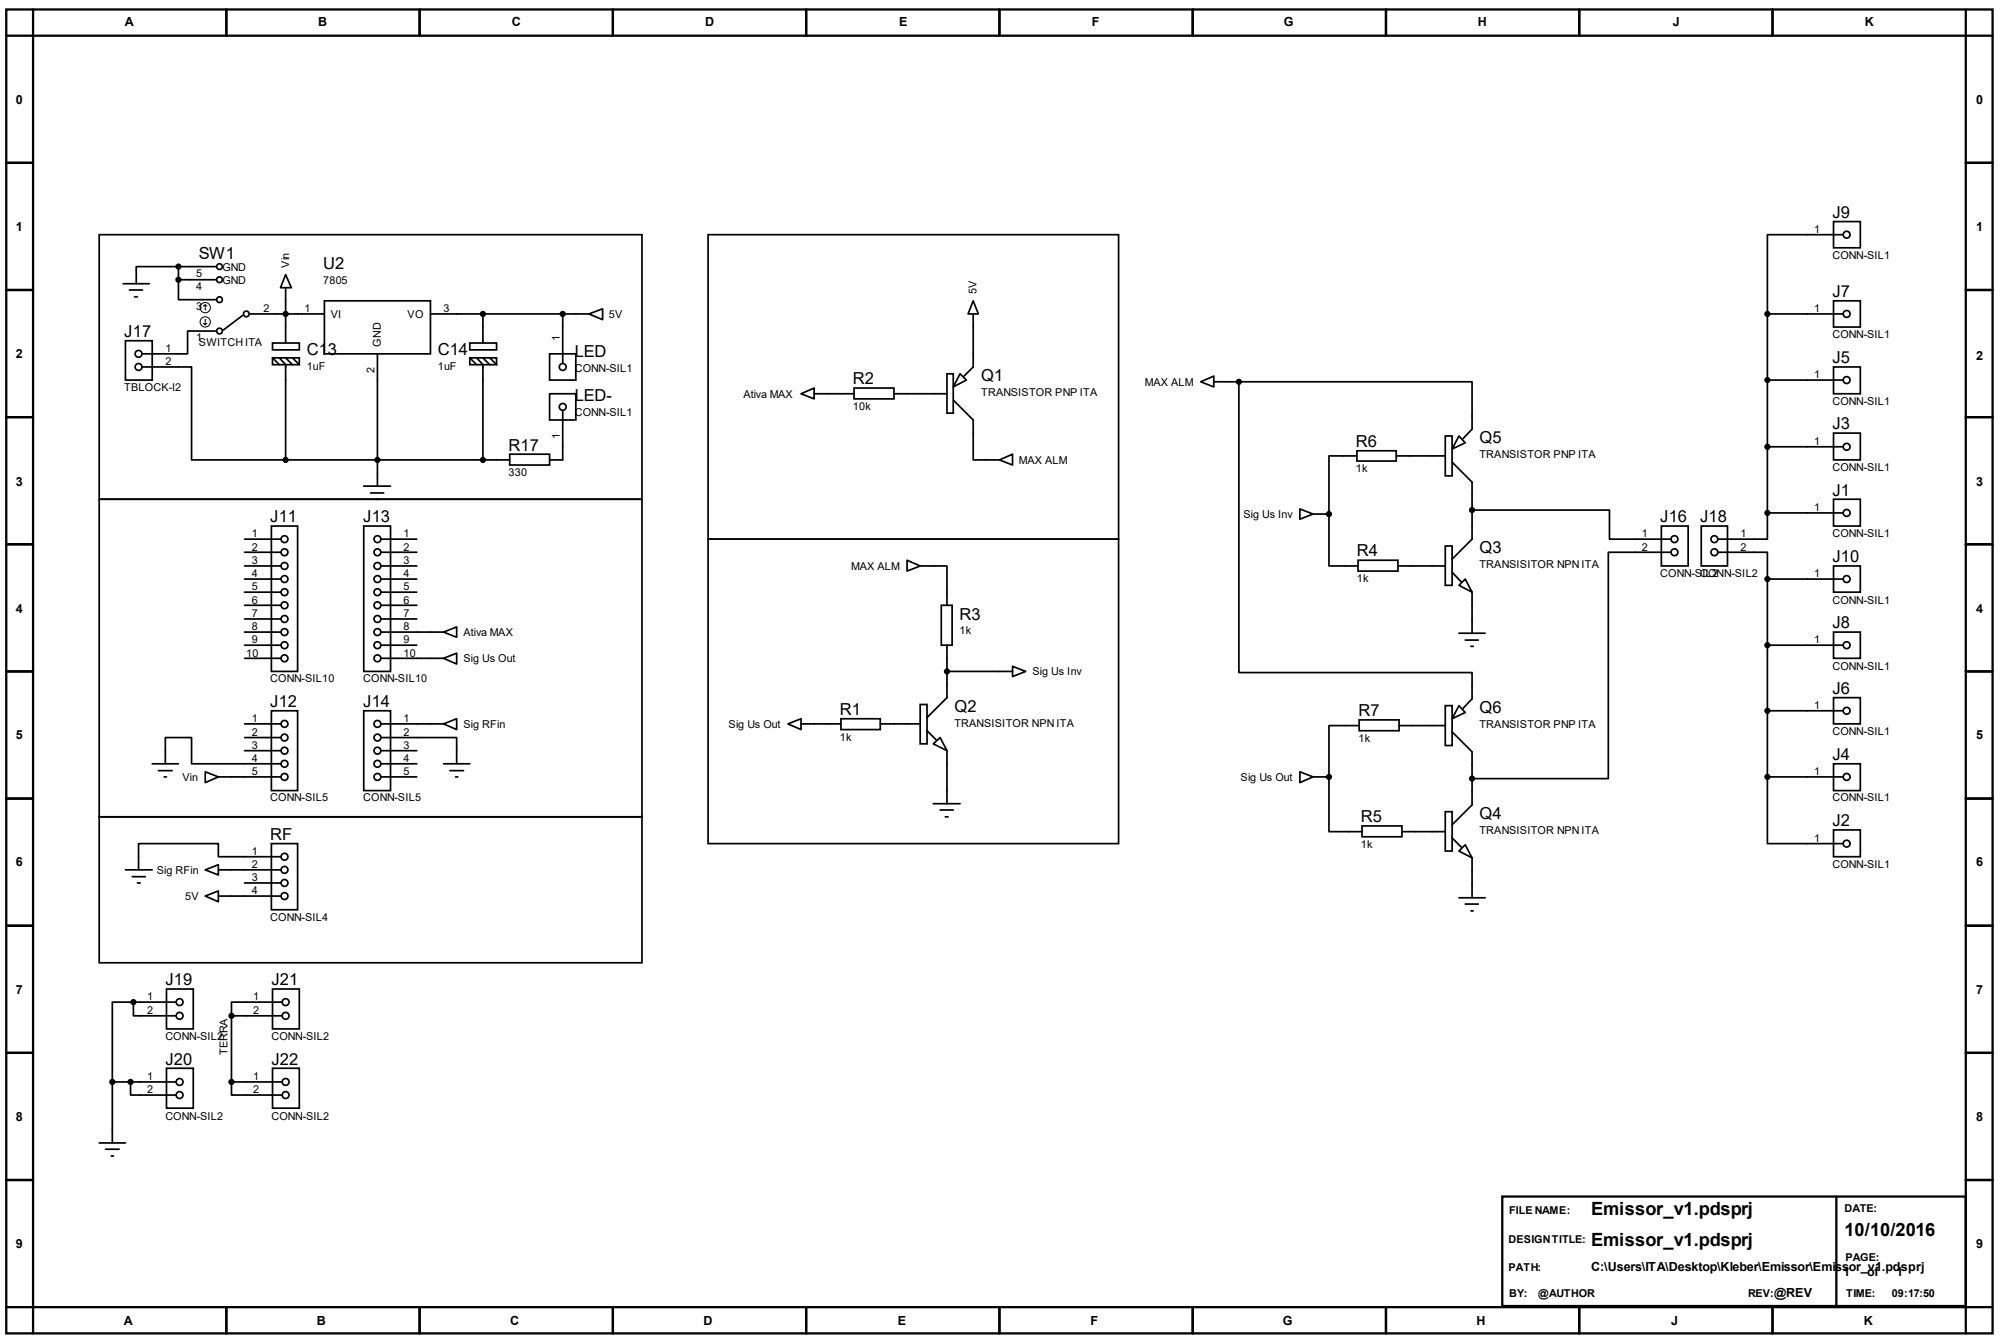
[picture p73: page 1]
