klebermc/ALOS/hardware/emitter/Emissor_v2.pdf

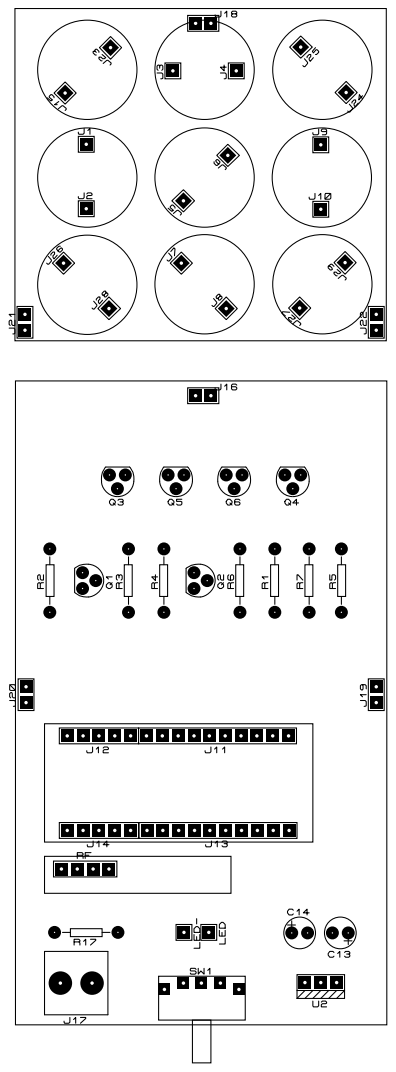
[picture p74: page 1]
