klebermc/ALOS/hardware/receiver/Receptora schematic.pdf

R4

C4

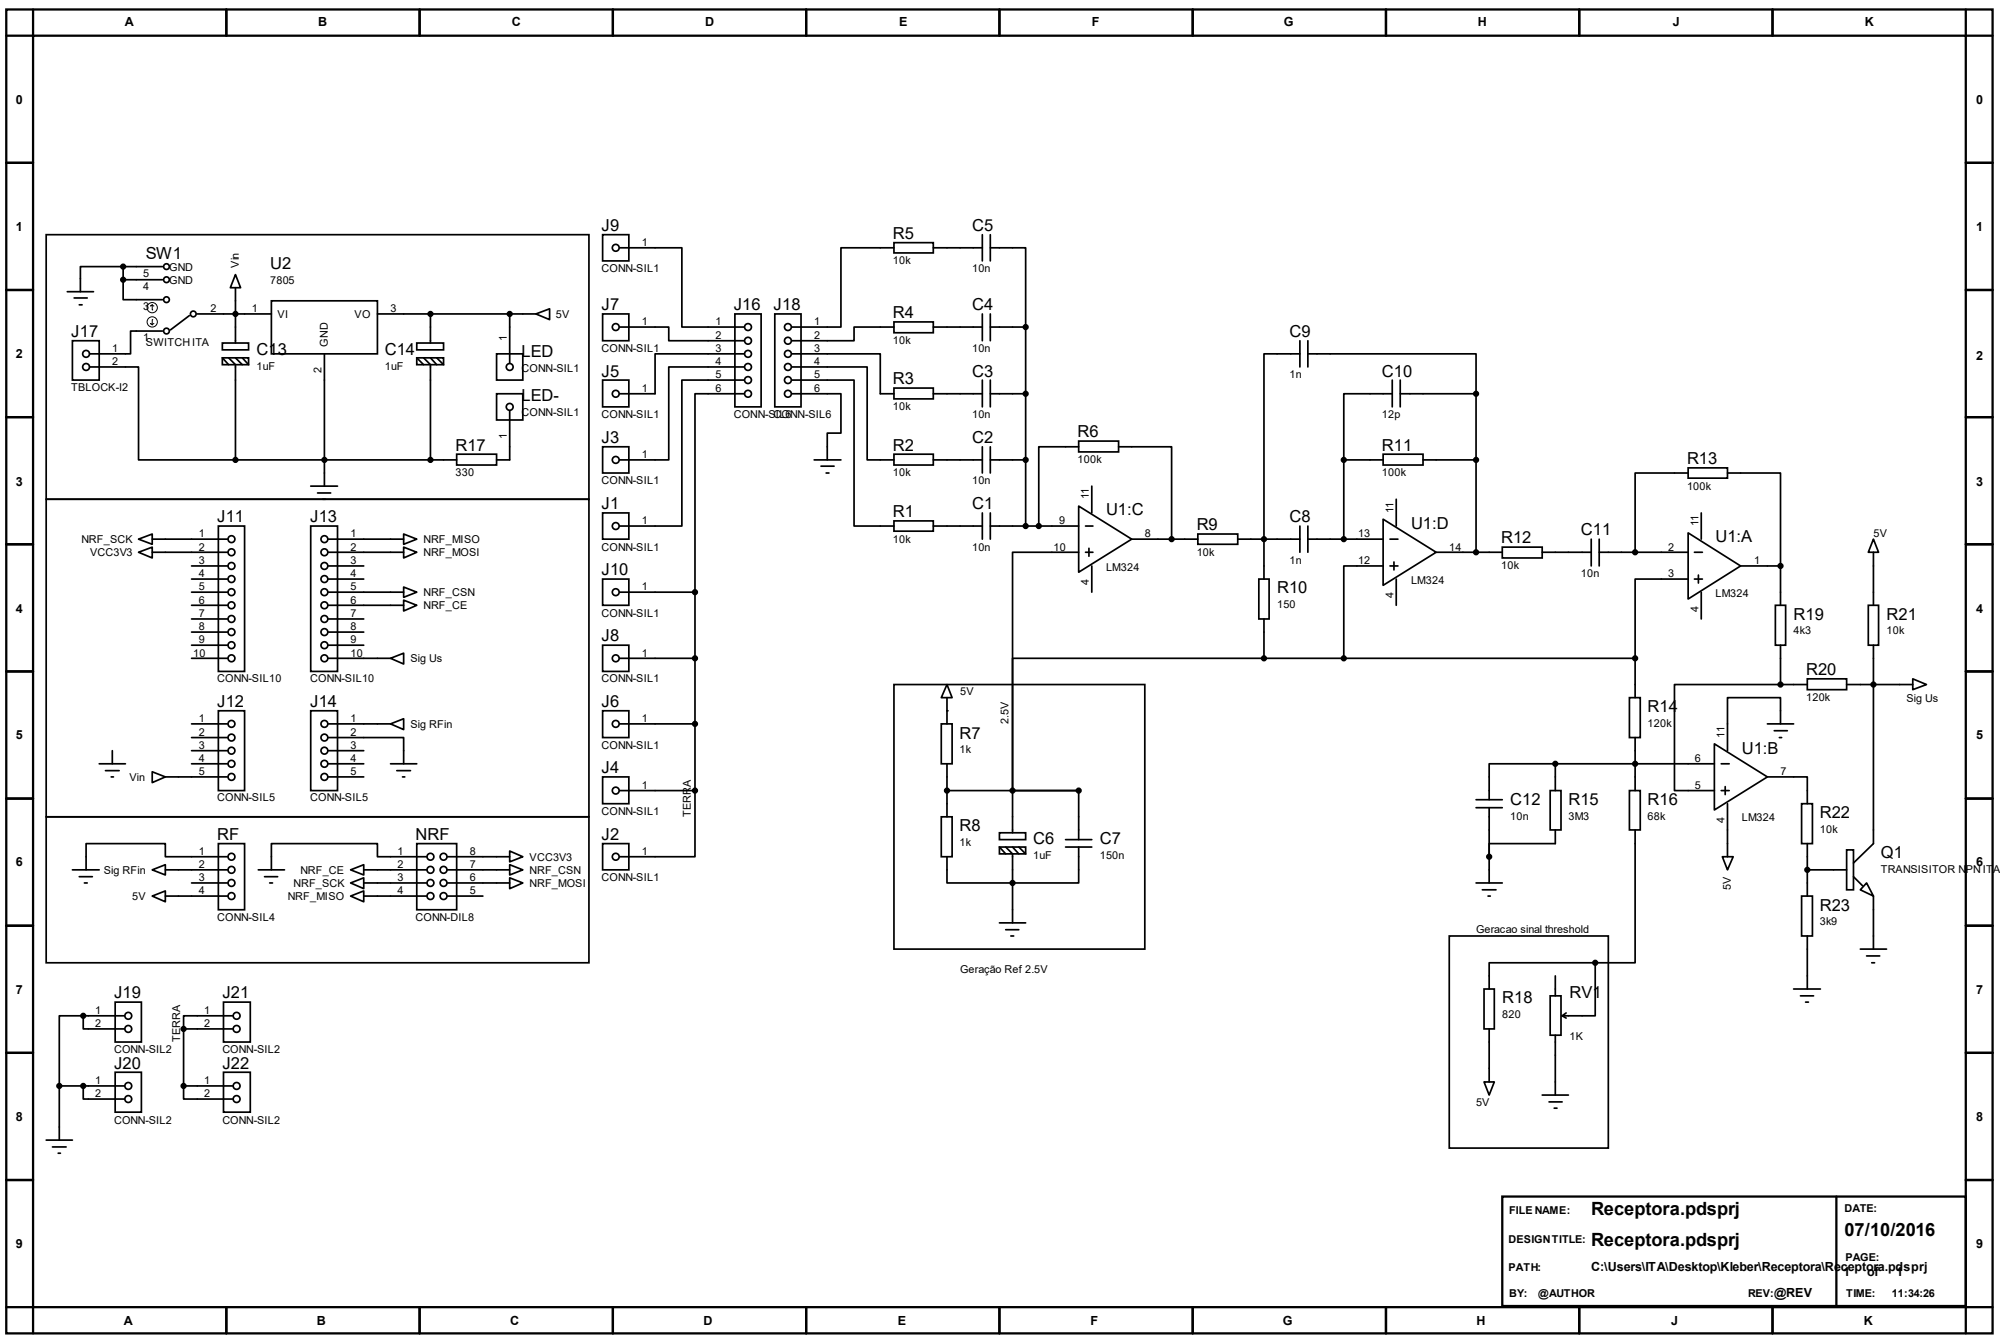
[picture p75: page 1]

FILE NAME:
DESIGN TITLE: Receptora.pdsprj
