klebermc/ALOS/(list of files, drawings)

Other design files:
hardware/emitter/Emissor_v1.pdsprj
hardware/emitter/Emissor_v2.pdsprj
hardware/emitter/Obsoleto/Emissor.pdsprj
hardware/fixed_station/Modulo fixo.pdsprj
hardware/receiver/Receptora.pdsprj
hardware/receiver/Receptora.v2/Receptora.v2.pdsprj
